Aryan-git-byte/FDC2214-Module/assets/cart.png

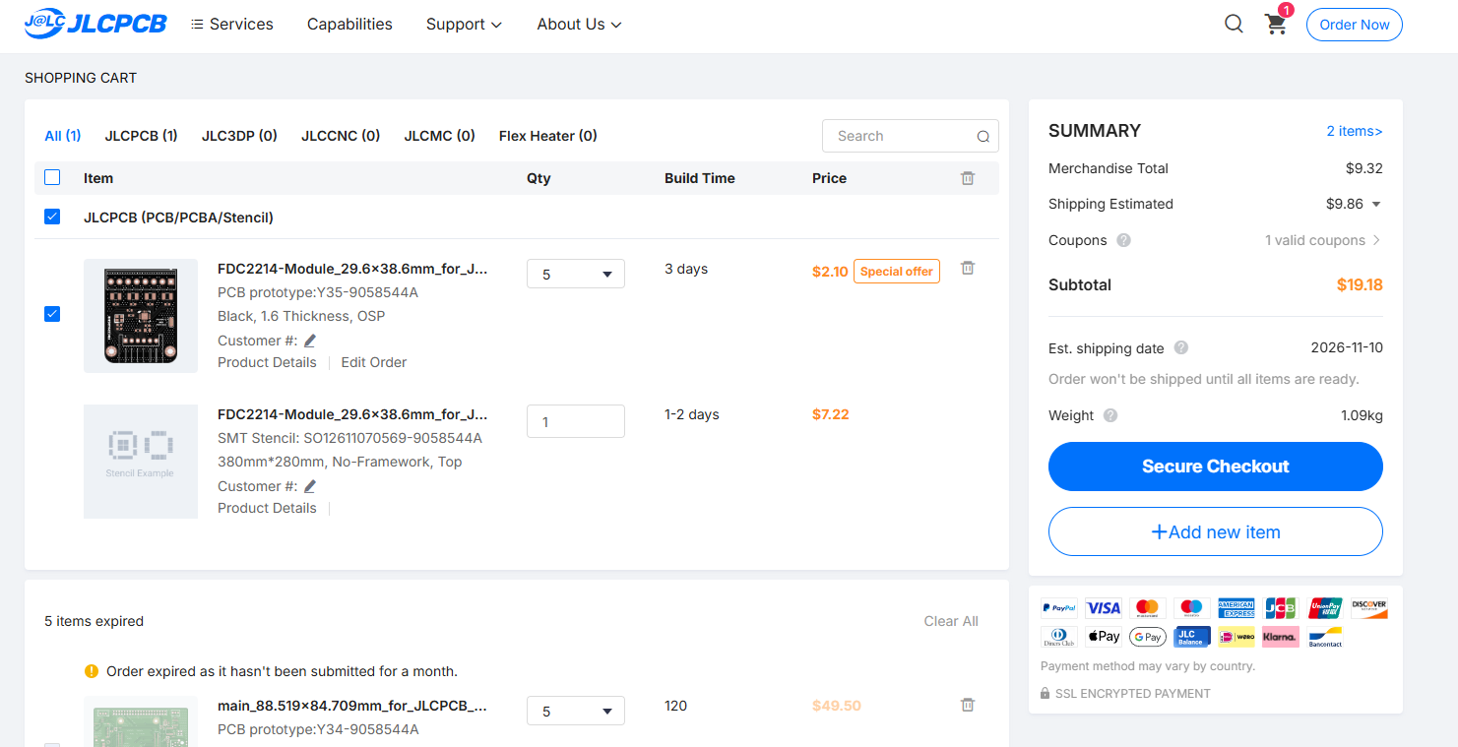
assets/cart.png
