Aryan-git-byte/FDC2214-Module/production/BOM.csv

Reference | Qty | Value | Footprint | Datasheet | Description | Link | Price
C1 | 1 | 1uF | Capacitor_SMD:C_0603_1608Metric | https://pim.murata.com/asset/pim4/ceramicCapacitorSMD/GRT188R61H105KE13-01A-EN_PDF_CERAMICCAPACITORSMD | CAP CER 1UF 50V X5R 0603 | https://www.digikey.in/en/products/detail/murata-electronics/GRT188R61H105KE13D/5416752 | ₹15.22
C2,C8 | 2 | 100nF | Capacitor_SMD:C_0603_1608Metric | https://yageogroup.com/content/datasheet/asset/file/KEM_C1002_X7R_SMD | CAP CER 0.1UF 50V X7R 0603 | https://www.digikey.in/en/products/detail/kemet/C0603C104K5RACTU/1465594 | ₹13.32
C3,C4,C5,C6 | 4 | 33pF/ 1% / C0G | Capacitor_SMD:C_0603_1608Metric | https://datasheets.kyocera-avx.com/C0GNP0-KGM.pdf | CAP CER 33PF 50V C0G/NP0 0603 | https://www.digikey.in/en/products/detail/kyocera-avx/KGM15ACG1H330FT/1599793 | ₹21.88
C7 | 1 | 10uF | Capacitor_SMD:C_0805_2012Metric | https://calchip.com/wp-content/uploads/2025/05/GMC-Series-3.pdf | CAP0805 X7R 10UF 10% 25V | https://www.digikey.in/en/products/detail/cal-chip-electronics-inc/GMC21X7R106K25NT/22639515 | ₹128.40
J1 | 1 | IN | TerminalBlock_Phoenix:TerminalBlock_Phoenix_PT-1,5-8-3.5-H_1x08_P3.50mm_Horizontal | https://www.sameskydevices.com/product/resource/tb0011-350.pdf | TERM BLOCK 8POS SIDE ENTRY 3.5MM | https://www.digikey.in/en/products/detail/same-sky-formerly-cui-devices/TB0011-350-08BE/27804493 | ₹193.07
J2 | 1 | Conn_01x06 | Connector_JST:JST_XH_S6B-XH-A_1x06_P2.50mm_Horizontal |  | Generic connector, single row, 01x06, script generated (kicad-library-utils/schlib/autogen/connector/) | https://www.digikey.in/en/products/detail/jst-sales-america-inc/S6B-XH-A/1651034 | ₹30.44
L1,L2,L3,L4 | 4 | CM322522-180KL | Inductor_SMD:L_1210_3225Metric_Pad1.42x2.65mm_HandSolder | https://www.bourns.com/docs/Product-Datasheets/cm322522.pdf | FIXED IND 18UH 110MA 3.3 OHM SMD | https://www.digikey.in/en/products/detail/bourns-inc/CM322522-180KL/2562573 | ₹24.73
R1,R2,R3 | 3 | 10k | Resistor_SMD:R_0603_1608Metric | https://www.vishay.com/docs/20035/dcrcwe3.pdf | RES SMD 10K OHM 1% 1/10W 0603 | https://www.digikey.in/en/products/detail/vishay-dale/CRCW060310K0FKEA/1174782 | ₹9.51
U1 | 1 | 625L3C040M00000 | 625L3C040M00000:OSC-SMD_4P-L2.5-W2.0-BL | https://www.ctscorp.com/Files/DataSheets/Passives/FCP/Clock-Oscillators/clock-ocillators-625-datasheet.pdf | XTAL OSC XO 40.0000MHZ CMOS SMD | https://www.digikey.in/en/products/detail/cts-frequency-controls/625L3C040M00000/1939224 | ₹154.08
U2 | 1 | FDC2214RGHR | FDC2214:WQFN-16_L4.0-W4.0-P0.50-BL-EP2.6 | https://www.ti.com/lit/ds/symlink/fdc2112.pdf | IC CAPACITIVE SENSING | https://www.digikey.in/en/products/detail/texas-instruments/FDC2214RGHR/5638173 | ₹937.78
