Aryan-git-byte/FDC2214-Module/assets/schematic.pdf

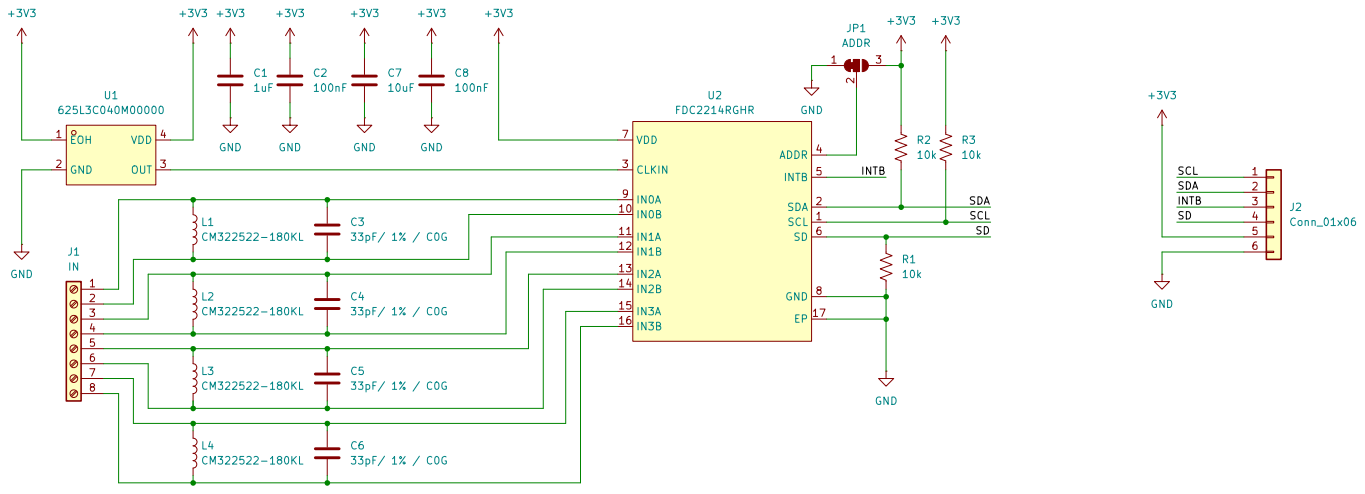
[picture p6: page 1]
