Aryan-git-byte/FDC2214-Module/kicad/FDC2214-Module.kicad_pcb

## KiCad design kicad/FDC2214-Module.kicad_pcb (2026-11-07)

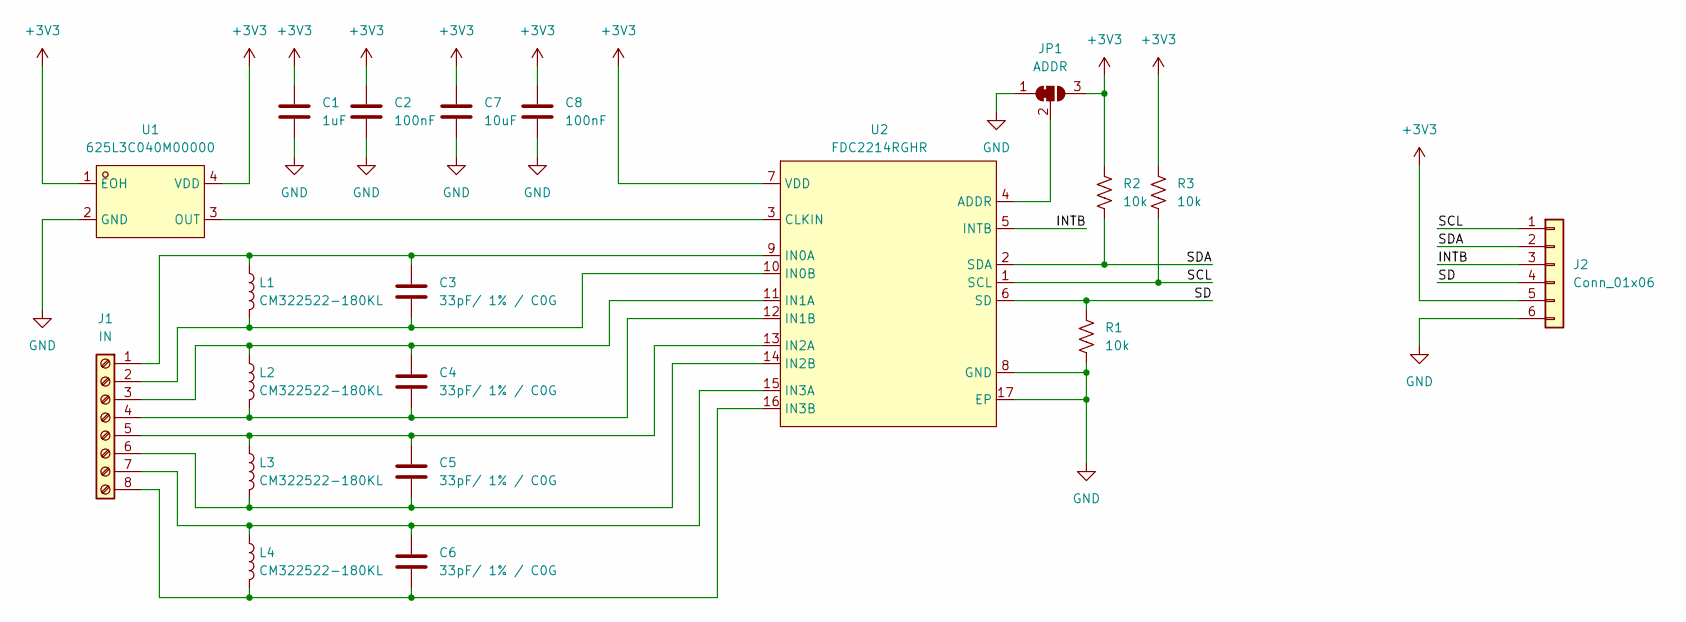
[picture p7: schematic FDC2214-Module.kicad_sch]

Parts:
C1: 1uF; C_0603_1608Metric
C2, C8: 100nF; C_0603_1608Metric
C3, C4, C5, C6: 33pF/ 1% / C0G; C_0603_1608Metric
C7: 10uF; C_0805_2012Metric
J1: IN; TerminalBlock_Phoenix_PT-1,5-8-3.5-H_1x08_P3.50mm_Horizontal
J2: Conn_01x06; JST_XH_S6B-XH-A_1x06_P2.50mm_Horizontal
JP1: ADDR; SolderJumper-3_P1.3mm_Bridged12_RoundedPad1.0x1.5mm
L1, L2, L3, L4: CM322522-180KL; L_1210_3225Metric_Pad1.42x2.65mm_HandSolder
R1, R2, R3: 10k; R_0603_1608Metric
U1: 625L3C040M00000; OSC-SMD_4P-L2.5-W2.0-BL
U2: FDC2214RGHR; WQFN-16_L4.0-W4.0-P0.50-BL-EP2.6

Connections:
+3V3: C1.1, C2.1, C7.1, C8.1, J2.5, JP1.3 (B), R2.1, R3.1, U1.1 (EOH), U1.4 (VDD), U2.7 (VDD)
/INTB: J2.3, U2.5 (INTB)
/SCL: J2.1, R3.2, U2.1 (SCL)
/SD: J2.4, R1.1, U2.6 (SD)
/SDA: J2.2, R2.2, U2.2 (SDA)
GND: C1.2, C2.2, C7.2, C8.2, J2.6, JP1.1 (A), R1.2, U1.2 (GND), U2.8 (GND), U2.17 (EP)
unnamed: C3.1, J1.1, L1.1, U2.9 (IN0A)
unnamed: C3.2, J1.2, L1.2, U2.10 (IN0B)
unnamed: C4.1, J1.3, L2.1, U2.11 (IN1A)
unnamed: C4.2, J1.4, L2.2, U2.12 (IN1B)
unnamed: C5.1, J1.5, L3.1, U2.13 (IN2A)
unnamed: C5.2, J1.6, L3.2, U2.14 (IN2B)
unnamed: C6.1, J1.7, L4.1, U2.15 (IN3A)
unnamed: C6.2, J1.8, L4.2, U2.16 (IN3B)
unnamed: JP1.2 (C), U2.4 (ADDR)
unnamed: U1.3 (OUT), U2.3 (CLKIN)

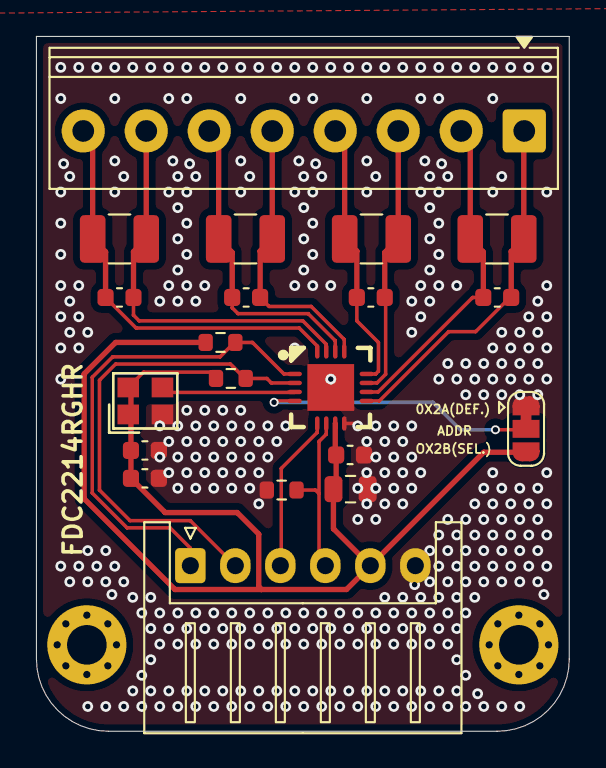
[picture p8: board FDC2214-Module.kicad_pcb from above]

Board: 2 copper layers, 29.6 x 38.6 mm, 20 parts (0 on the bottom side), 16 nets.
